nsaspook/mass_slit/masl.png

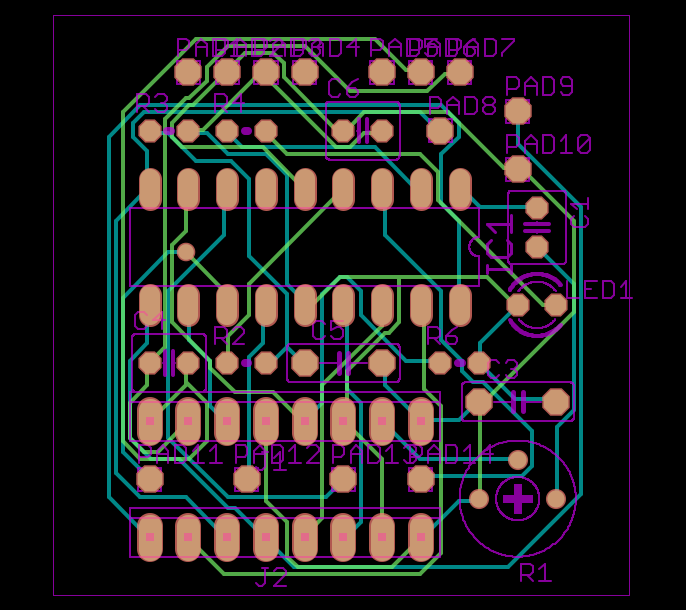
masl.png
