nsaspook/mass_slit/mass_slit.pdf

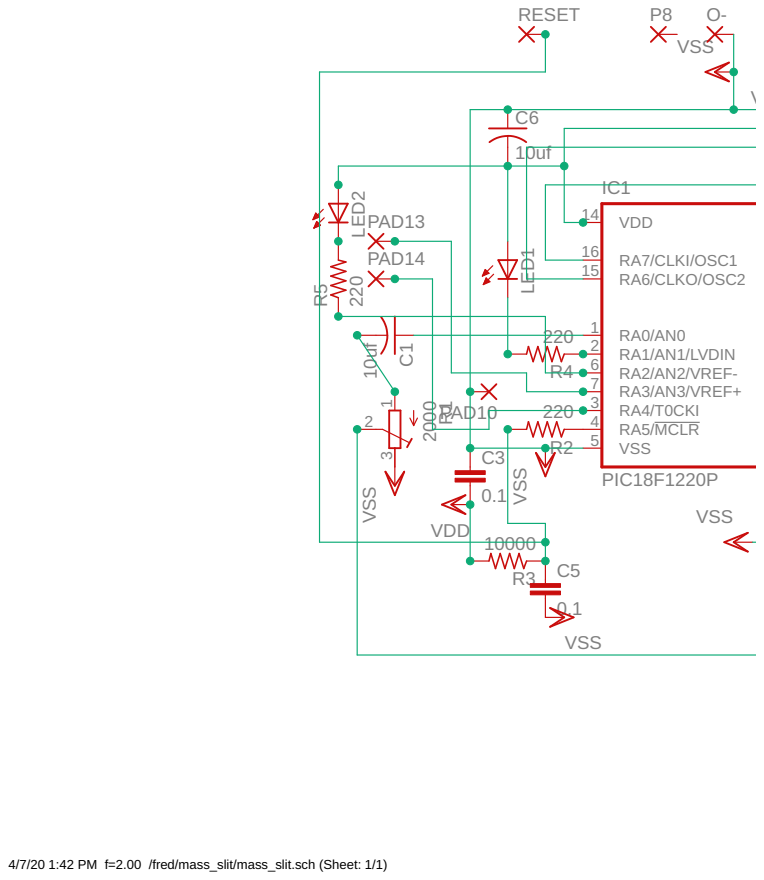
[picture p7: page 1]

4/7/20 1:42 PM f=2.00 /fred/mass_slit/mass_slit.sch (Sheet: 1/1)

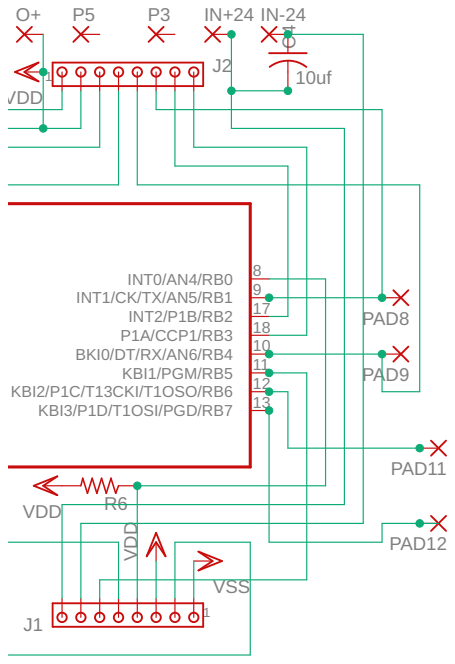
[picture p8: page 2]
