nsaspook/mass_slit/door_sensor.pdf

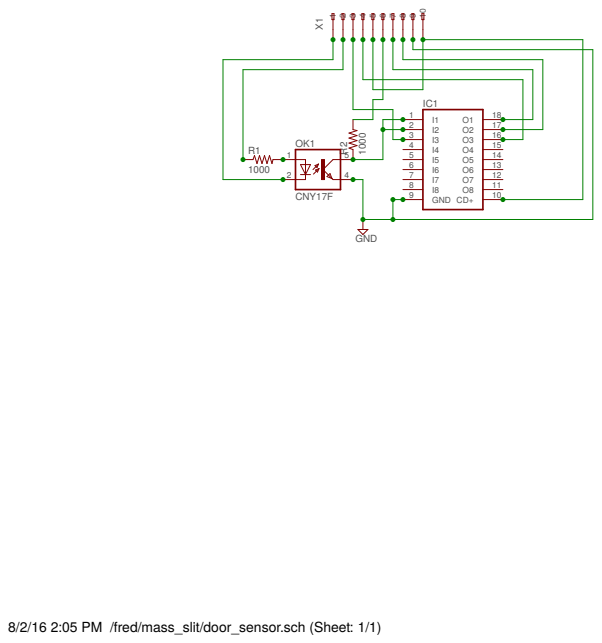
[picture p9: page 1]

2 | 17 O3
3 | 16 O4

8/2/16 2:05 PM /fred/mass_slit/door_sensor.sch (Sheet: 1/1)
