nsaspook/mass_slit/mass_slit_scm.pdf

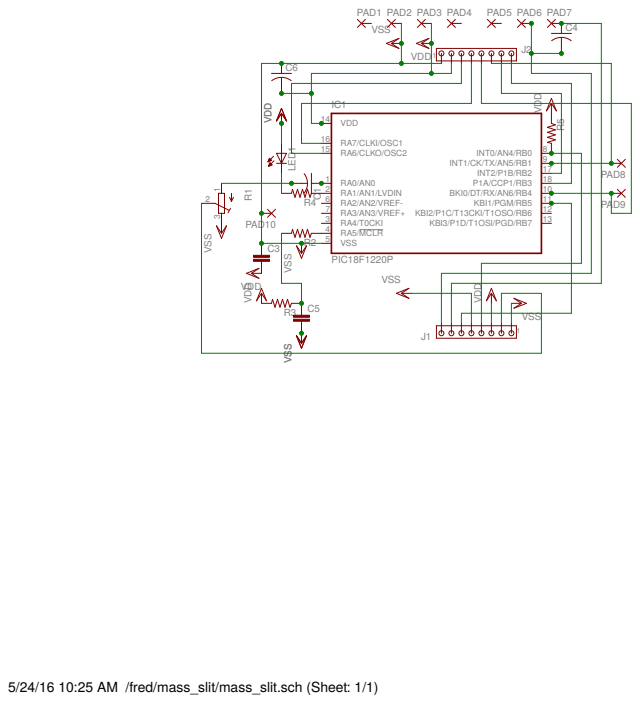
[picture p10: page 1]

5/24/16 10:25 AM /fred/mass_slit/mass_slit.sch (Sheet: 1/1)
