nsaspook/mass_slit/mass_slit.brd

## EAGLE design mass_slit.brd (2021-06-08)

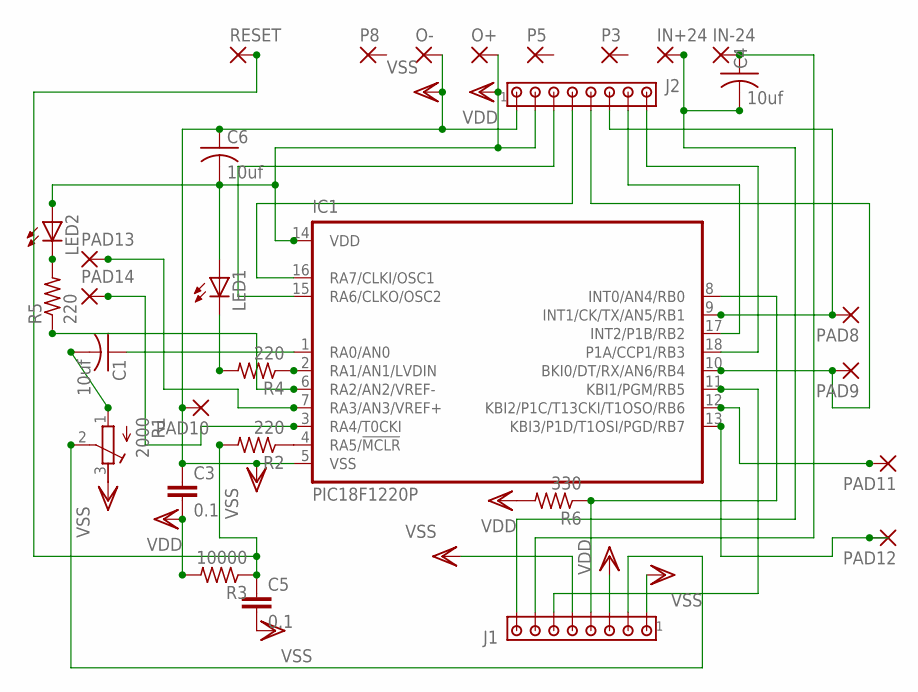
[picture p11: schematic mass_slit.sch]

Parts:
C1, C4, C6: 10uf; C025-040X050
C3, C5: 0.1; C5B2.5
IC1: PIC18F1220P; DIL18
IN+24: 1,6/0,9
IN-24: 1,6/0,9
J1, J2: MTA08-100; 10X08MTA
LED1, LED2: LED3MM
O+: 1,6/0,9
O-: 1,6/0,9
P3, P5, P8: 1,6/0,9
PAD8, PAD9, PAD10, PAD11, PAD12, PAD13, PAD14: 1,6/0,9
R1: 2000; RTRIM3339P
R2, R4, R5: 220; 0204V
R3: 10000; 0204V
R6: 330; 0204V
RESET: 1,6/0,9

Connections:
+24: C4.2, IN+24.1, J1.8
-24: C4.1, IN-24.1, J1.7
unnamed: IC1.10 (BKI0/DT/RX/AN6/RB4), J2.5, PAD9.1
unnamed: IC1.4 (RA5/!MCLR), R2.1
unnamed: C1.1, IC1.1 (RA0/AN0)
unnamed: C1.2, R1.1 (A)
unnamed: C5.1, R2.2, R3.1, RESET.1
unnamed: IC1.2 (RA1/AN1/LVDIN), R4.1
unnamed: IC1.8 (INT0/AN4/RB0), J1.4, R6.1
unnamed: IC1.13 (KBI3/P1D/T1OSI/PGD/RB7), PAD12.1
unnamed: J1.2, R1.2 (S)
unnamed: IC1.9 (INT1/CK/TX/AN5/RB1), J2.6, PAD8.1
unnamed: LED1.K (C), R4.2
unnamed: IC1.11 (KBI1/PGM/RB5), J1.6
unnamed: IC1.17 (INT2/P1B/RB2), J2.7
unnamed: IC1.18 (P1A/CCP1/RB3), J2.8
unnamed: IC1.16 (RA7/CLKI/OSC1), J2.4
unnamed: IC1.15 (RA6/CLKO/OSC2), J2.3
unnamed: IC1.12 (KBI2/P1C/T13CKI/T1OSO/RB6), PAD11.1
unnamed: IC1.7 (RA3/AN3/VREF+), PAD13.1
unnamed: IC1.3 (RA4/T0CKI), PAD14.1
unnamed: IC1.6 (RA2/AN2/VREF-), R5.1
unnamed: LED2.K (C), R5.2
VDD: C3.2, C6.2, IC1.14 (VDD), J1.3, J2.2, LED1.A, LED2.A, O+.1, R3.2, R6.2
VSS: C3.1, C5.2, C6.1, IC1.5 (VSS), J1.1, J1.5, J2.1, O-.1, PAD10.1, R1.3 (E)

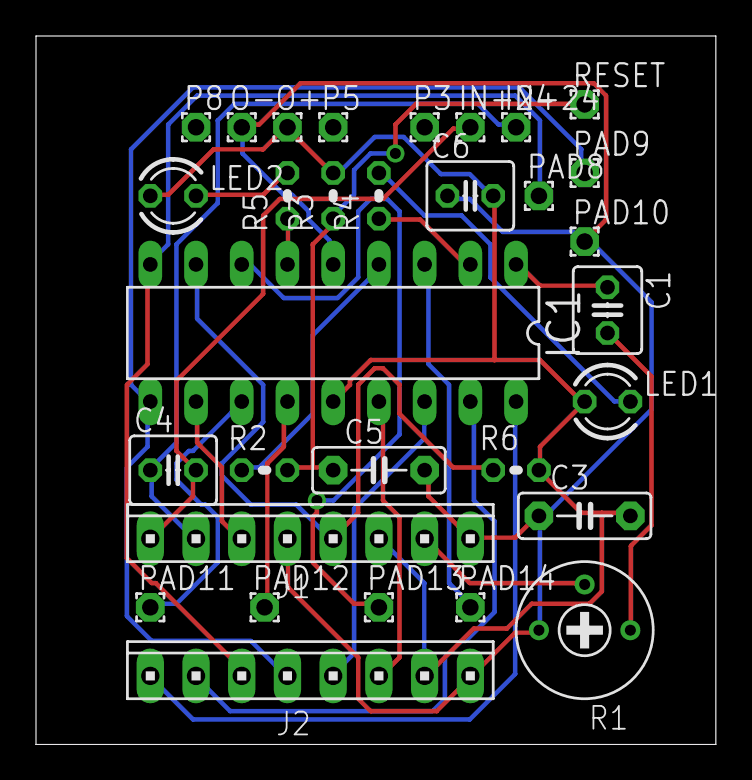
[picture p12: board mass_slit.brd from above]

Board: 2 copper layers, 37.8 x 39.4 mm, 31 parts (0 on the bottom side), 25 nets.
