nsaspook/mass_slit/door_sensor.brd

## EAGLE design door_sensor.brd (2016-08-03)

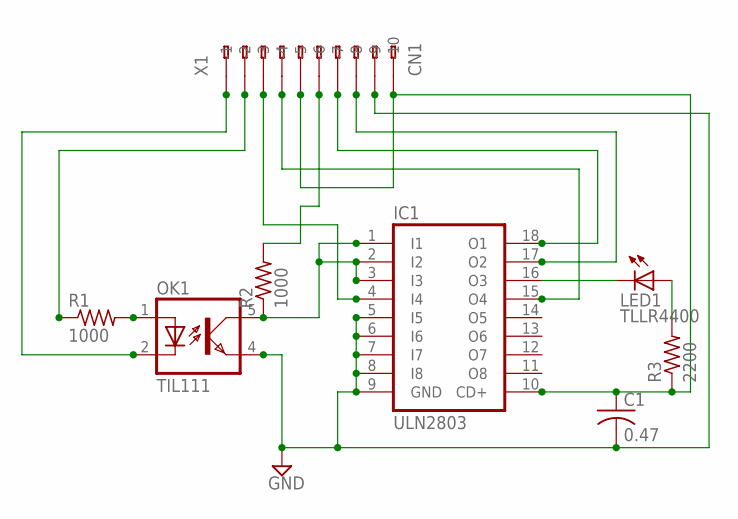
[picture p13: schematic door_sensor.sch]

Parts:
C1: 0.47; C025-024X044
IC1: ULN2803; DIL18
LED1: TLLR4400; LED3MM
OK1: TIL111; DIL06
R1, R2: 1000; 0204V
R3: 2200; 0204V
X1: CN1; 233-210

Connections:
GND: C1.2, IC1.5 (I5), IC1.6 (I6), IC1.7 (I7), IC1.8 (I8), IC1.9 (GND), OK1.4 (EMIT), X1.A9 (-9)
unnamed: OK1.1 (A), R1.2
unnamed: OK1.2 (C), X1.A1 (-1)
unnamed: IC1.4 (I4), X1.A3 (-3)
unnamed: IC1.1 (I1), IC1.2 (I2), IC1.3 (I3), OK1.5 (COL), R2.1
unnamed: IC1.15 (O4), X1.A4 (-4)
unnamed: R1.1, X1.A2 (-2)
unnamed: R2.2, X1.A6 (-6)
unnamed: IC1.18 (O1), X1.A7 (-7)
unnamed: IC1.17 (O2), X1.A8 (-8)
unnamed: LED1.A, R3.2
unnamed: C1.1, IC1.10 (CD+), R3.1, X1.A5 (-5), X1.A10 (-10)
unnamed: IC1.16 (O3), LED1.K (C)

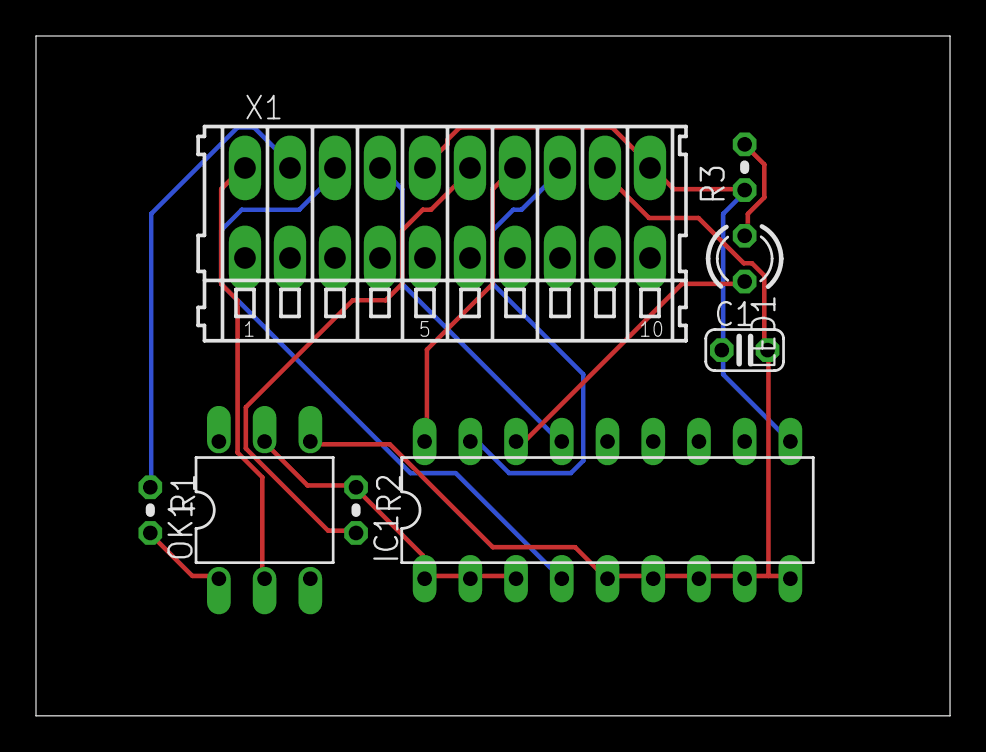
[picture p14: board door_sensor.brd from above]

Board: 2 copper layers, 50.8 x 37.8 mm, 8 parts (0 on the bottom side), 13 nets.
