nsaspook/mass_slit/cm17a.c

//	PIC CM17A Firecracker interface Version 1.1
#include <p18f1320.h>
#include <delays.h>
#include "cm17a.h"

/* Arduino Interface to the CM17A Wireless X10 dongle. BroHogan 7/19/08
 * adapted to Microchip C18 on PIC18F1320 8/15/2011 NsaSpook
 * Change cm17a_delay to alter transmission speeds and bit delays
 *
 * The CM17A gets it power and data using only the RTS, CTS, & Gnd lines.
 * A MAX232 is not req. (0/+5V work OK) If MAX232 IS used reverse all HIGHs & LOWS
 * Signal      RTS DTR        Standby | '1' | Wait | '0' | Wait | '1' | Wait...
 * Reset        0   0         _____________________       _____________________
 * Logical '1'  1   0   RTS _|                     |_____|
 * Logical '0'  0   1         ________       ___________________       ________
 * Standby      1   1   DTR _|        |_____|                   |_____|
 *
 * MINIMUM time for the '1', '0' and 'Wait' states is 0.5ms.
 * At least one signal must be high to keep CM17A powered while transmitting.
 * Each xmit is 40 bits -> "Header" 16 bits,  "Data" 16 bits, "Footer" 8 bits
 * CONNECTION: RTS -> DB9 pin 7.  DTR -> DB9 pin 4. Gnd. -> DB9 pin 5.
 */

void xmitCM17A_cmd(char, unsigned char, unsigned char);
void xmitCM17A(char, unsigned char, unsigned char, unsigned char);
void cm17a_delay(unsigned char);


#define BIT_DELAY 1                    // ms delay between bits (0.5ms min.)
#define ON     0                       // command for ON
#define OFF    1                       // command for OFF
#define BRIGHT 2                       // command for 20% brighten
#define DIM    3                       // command for 20% dim
#define	LOW		0
#define	HIGH	1

#define	CODE_HOUSE		'M'
#define	CODE_DEVICE		6

volatile unsigned long x10_cmdcount;

rom const unsigned int houseCode[16] = {
    0x6000, // A
    0x7000, // B
    0x4000, // C
    0x5000, // D
    0x8000, // E
    0x9000, // F
    0xA000, // G
    0xB000, // H
    0xE000, // I
    0xF000, // J
    0xC000, // K
    0xD000, // L
    0x0000, // M
    0x1000, // N
    0x2000, // O
    0x3000, // P
};

rom const unsigned int deviceCode[16] = {
    0x0000, // 1
    0x0010, // 2
    0x0008, // 3
    0x0018, // 4
    0x0040, // 5
    0x0050, // 6
    0x0048, // 7
    0x0058, // 8
    0x0400, // 9
    0x0410, // 10
    0x0408, // 11
    0x0418, // 12
    0x0440, // 13
    0x0450, // 14
    0x0448, // 15
    0x0458, // 16
};

rom const unsigned int cmndCode[] = {
    0x0000, // ON
    0x0020, // OFF
    0x0088, // 20% BRIGHT (0x00A8=5%)
    0x0098, // 20% DIM    (0x00B8=5%)
};

void cm17a_delay(unsigned char dtime) // really slow data rate for transmitted symbols and spacing
{
    unsigned char bit_delay;

    for (bit_delay = 0; bit_delay < X10_DELAY; bit_delay++) { // Change X10_DELAY to match speed of PIC processor, 3 works with 8MHZ PIC18F1320 internal clock
        Delay1KTCYx(dtime);
    }
}

void setup_cm17a(void) {
    CM17A_PORT_OUT = CM17A_PINS; // set cm17a port to digital outout for CM17A control
    RTS_pin = 0;
    DTR_pin = 0;
    BELL = 0; // set cm17a port to all lows to reset module and bell
}

void loop_cm17a(void) // Sample Commands
{
    cm17a_delay(200);
    xmitCM17A(CODE_HOUSE, CODE_DEVICE, ON, 1);
    xmitCM17A(CODE_HOUSE, CODE_DEVICE, ON, 1);
    xmitCM17A(CODE_HOUSE, CODE_DEVICE, ON, 1);
    xmitCM17A(CODE_HOUSE, CODE_DEVICE, OFF, 1);
    xmitCM17A(CODE_HOUSE, CODE_DEVICE, OFF, 1);
    xmitCM17A(CODE_HOUSE, CODE_DEVICE, OFF, 1);
}

void xmitCM17A(char house, unsigned char device, unsigned char cmnd, unsigned char repeat) {
    unsigned char i;
    for (i = 0; i <= repeat; i++) xmitCM17A_cmd(house, device, cmnd);
}

void xmitCM17A_cmd(char house, unsigned char device, unsigned char cmnd) {
    unsigned int dataBuff = 0;
    unsigned char messageBuff[5], i, mask;

    x10_cmdcount++;
    // Build Message by ORing the parts together. No device if Bright or Dim
    if (cmnd == ON | cmnd == OFF) {
        dataBuff = (houseCode[house - 'A'] | deviceCode[device - 1] | cmndCode[cmnd]);
    } else {
        dataBuff = houseCode[house - 'A'] | cmndCode[cmnd];
    }

    // Build a string for the whole message . . .
    messageBuff[0] = 0xD5; // Header byte 0 11010101 = 0xD5
    messageBuff[1] = 0xAA; // Header byte 1 10101010 = 0xAA
    messageBuff[2] = dataBuff >> 8; // MSB of dataBuff
    messageBuff[3] = dataBuff & 0xFF; // LSB of dataBuff
    messageBuff[4] = 0xAD; // Footer byte 10101101 = 0xAD

    // Now send it out to CM17A . . .
    DTR_pin = LOW; // reset device - both low is power off
    RTS_pin = LOW;
    cm17a_delay(BIT_DELAY);

    DTR_pin = HIGH; // standby mode - supply power
    RTS_pin = HIGH;
    cm17a_delay(35); // need extra time for it to settle

    for (i = 0; i < 5; i++) {
        for (mask = 0x80; mask; mask >>= 1) {
            if (mask & messageBuff[i]) {
                DTR_pin = LOW; // 1 = RTS HIGH/DTR-LOW
            } else {
                RTS_pin = LOW; // 0 = DTR-HIGH/RTS-LOW
            }
            cm17a_delay(BIT_DELAY); // delay between bits

            DTR_pin = HIGH; // wait state between bits
            RTS_pin = HIGH;
            cm17a_delay(BIT_DELAY);
        }
    }
    cm17a_delay(100); // wait required before next xmit
    DTR_pin = LOW; // reset device - both low is power off
    RTS_pin = LOW;
    cm17a_delay(BIT_DELAY);
}
