nsaspook/mass_slit/(commit log)

2016-07-26 update all files
    [mass_slit.brd, mass_slit.sch]
2019-01-28 updates, fast spinup at power up
